alcruzr/UPS/Pictures/overall 5.jpg

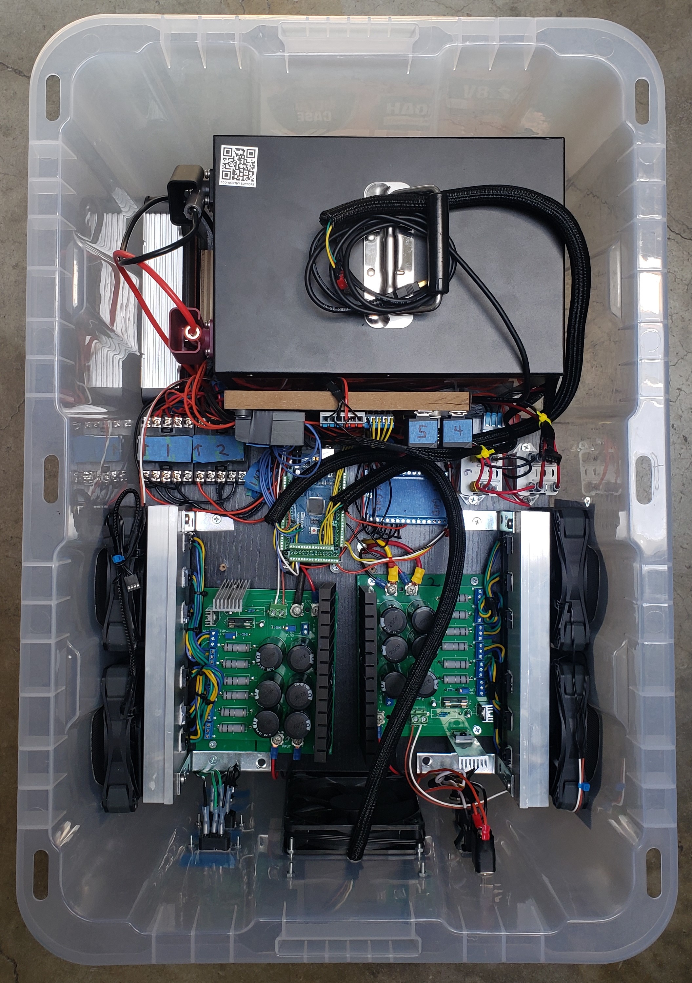
Pictures/overall 5.jpg
