alcruzr/UPS/Pictures/overall 4.jpg

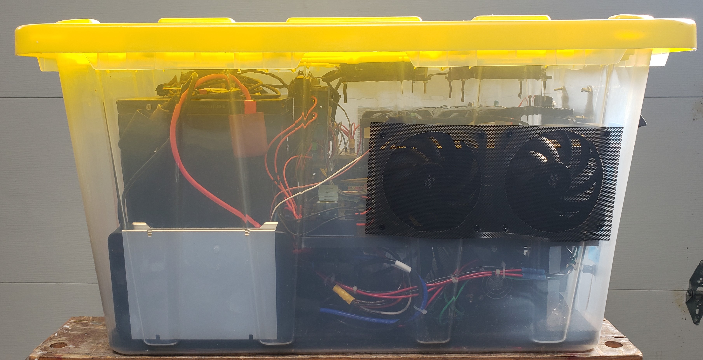
Pictures/overall 4.jpg
