alcruzr/UPS/Pictures/front.jpg

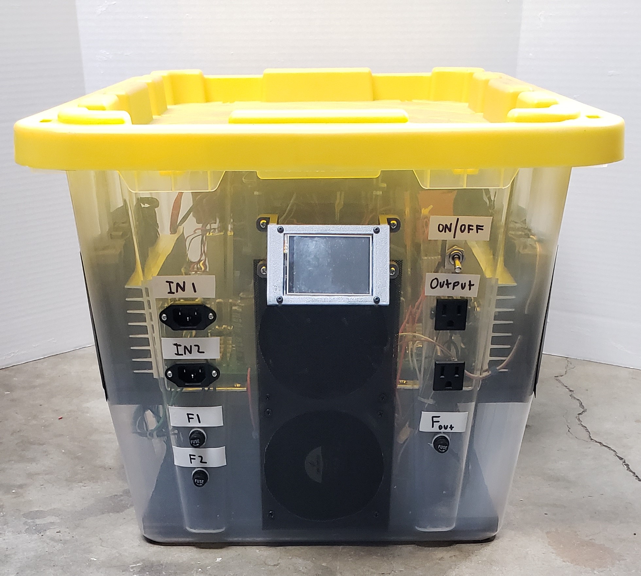
Pictures/front.jpg
