alcruzr/UPS/Pictures/screen.jpg

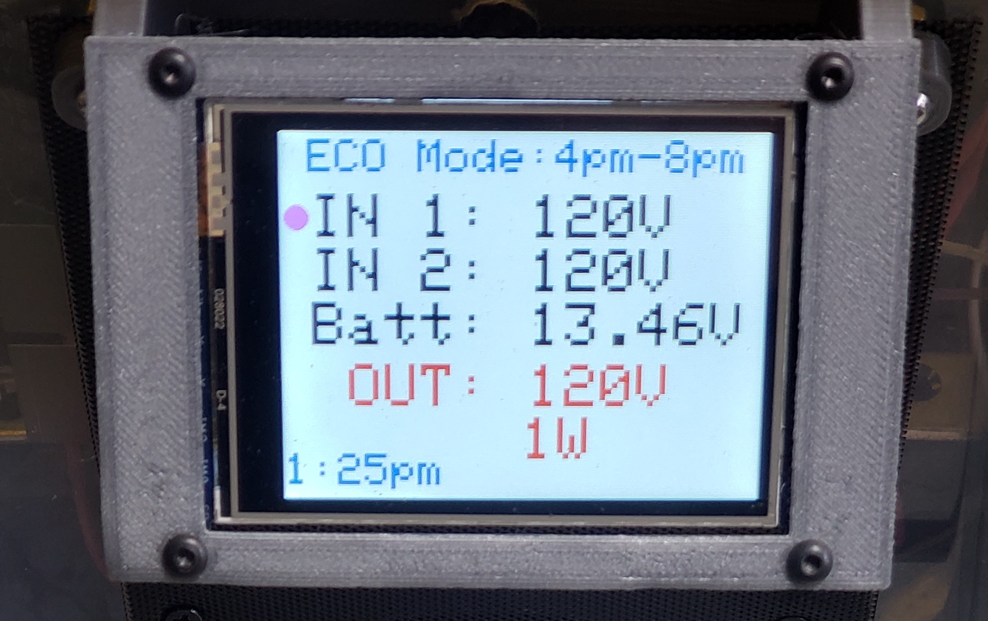
Pictures/screen.jpg
