alcruzr/UPS/UPS BOM-Final.xlsx

Part | Price | Required per Unit | Total Part Price
120V 40A AC Relay | $20.95 | 2 | $41.90 | https://www.lvelectronics.com/details/item?itemid=PICKER%20PC740-2C-C3-120A#
5V DC Relay | $25.07 | 2 | $50.14 | https://www.digikey.com/en/products/detail/panasonic-electric-works/SP2-DC5V/649191
5V DC Relay Screw Terminal | $11.32 | 2 | $22.64 | https://www.digikey.com/en/products/detail/panasonic-electric-works/SP2-SF/570886
6V DC Relay SPDT 40A | $3.15 | 2 | $6.30 | https://www.digikey.com/en/products/detail/cit-relay-and-switch/A2M1CSQ6VDC1-6/14001769
117/24V 40A AC Transformer | $212.30 | 1 | $212.30 | https://www.newark.com/hammond/1182w12/toroid-1000va-50-60hz-12-12v-rohs/dp/31AJ8188?ost=1182w12
Lithium Battery (150Ah) | $299.99 | 1 | $299.99 | https://www.amazon.com/ECO-WORTHY-Rechargeable-Phosphate-Protection-Motorhome/dp/B096FGMLNZ | https://www.eco-worthy.com/products/lifepo4-12v-150ah-lithium-iron-phosphate-battery?gad_source=1
AC Voltage Measurement Module | $6.99 | 3 | $20.97 | https://www.amazon.com/dp/B07D1WP884?psc=1&ref=ppx_yo2ov_dt_b_product_details
Microcontroller-Arduino Mega 2560 | $48.40 | 1 | $48.40
TFT Display (+$6 shipping) | $29.95 | 1 | $29.95 | https://www.adafruit.com/product/1770
RTC (Real Time Clock) | $11.49 | 1 | $11.49 | https://www.amazon.com/gp/product/B082LTHR28/ref=ppx_yo_dt_b_asin_image_o00_s01?ie=UTF8&psc=1
Buck Converter | $1.29 | 3 | $3.87 | https://www.amazon.com/gp/product/B07VVXF7YX/ref=ppx_yo_dt_b_search_asin_image?ie=UTF8&th=1
ULN2803A-Relay Driver Board | $3.22 | 1 | $3.22 | https://www.amazon.com/dp/B08QNHW4G4?psc=1&ref=ppx_yo2ov_dt_b_product_details
Fuse Holder | $1.99 | 3 | $5.97 | https://www.amazon.com/Joinfworld-Holder-Holders-Pre-Soldered-Fast-Blow/dp/B0BF9LDW1P?cv_ct_cx=fuse+holder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
SPST Switch | $2.21 | 1 | $2.21 | https://www.amazon.com/gp/product/B01M3U9V8Y/ref=ppx_yo_dt_b_search_asin_title?ie=UTF8&th=1
Inverter | $56.96 | 1 | $56.96 | https://www.amazon.com/gp/product/B09JZ2HTY9/ref=ppx_yo_dt_b_search_asin_title?ie=UTF8&psc=1
Charger | $108.99 | 1 | $108.99 | https://www.amazon.com/gp/product/B0BZCXNHDV/ref=ppx_yo_dt_b_search_asin_title?ie=UTF8&psc=1 | https://www.eco-worthy.com/collections/charge-controllers-inverters/products/12v-20a-40a-dc-to-dc-charger-on-board-mppt-battery-charger
Battery Ring Terminals | $2.49 | 2 | $4.98 | https://www.amazon.com/dp/B08HR1BD62?psc=1&ref=ppx_yo2ov_dt_b_product_details
AC Input Connectors | $4.17 | 2 | $8.34 | https://www.amazon.com/gp/product/B081VJ22G4/ref=ppx_yo_dt_b_search_asin_title?ie=UTF8&psc=1
AC Output Connectors | $2.99 | 2 | $5.98 | https://www.amazon.com/gp/product/B092VQNKN7/ref=ppx_yo_dt_b_search_asin_title?ie=UTF8&psc=1
Fans | $5.99 | 8 | $47.92 | https://www.amazon.com/gp/product/B0CLGMH1R8/ref=ppx_yo_dt_b_search_asin_title?ie=UTF8&th=1
Enclosure | $15.98 | 1 | $15.98 | https://www.homedepot.com/p/HDX-27-Gal-Storage-Tote-in-Clear-with-Yellow-Lid-206231/317211766
Rectifier PCB | $0.00 | 2 | $0.00
TIP2955 Transistor | $2.37 | 12 | $28.44 | https://www.digikey.com/en/products/detail/stmicroelectronics/TIP2955/603633
LT317A Voltage Regulator | $6.44 | 2 | $12.88 | https://www.digikey.com/en/products/detail/analog-devices-inc/LT317AT-PBF/891897
Diode | $2.22 | 2 | $4.44 | https://www.digikey.com/en/products/detail/stmicroelectronics/STPS60SM200CW/2700612
Full Bridge Rectifier | $1.85 | 2 | $3.70 | https://www.digikey.com/en/products/detail/panjit-international-inc/GBJ5010-T0-00601/16639574
Capacitor-10000uF 50V | $5.73 | 12 | $68.76 | https://www.digikey.com/en/products/detail/cornell-dubilier-knowles/380LX103M050J052/1699321
Capacitor-1uF 25V | $0.00 | 2 | $0.00
Capacitor-0.1uF 25V | $0.00 | 2 | $0.00
Resistor-50ohm | $0.00 | 2 | $0.00
Resistor-0.1ohm 5W | $0.00 | 12 | $0.00
Screw Terminal-Large-2 Pin | $1.25 | 2 | $2.50 | https://www.digikey.com/en/products/detail/amphenol-anytek/T70243500000G/2261340
Screw Terminal-Small-3 Pin (for transistor connections) | $0.14 | 12 | $1.68 | https://www.amazon.com/gp/product/B07H5G7GC6/ref=ppx_yo_dt_b_search_asin_title?ie=UTF8&psc=1
Screw Post | $4.51 | 8 | $36.08 | https://www.digikey.com/en/products/detail/w%C3%BCrth-elektronik/74655095R/6643999
Fuse Holder | $1.05 | 2 | $2.10 | https://www.digikey.com/en/products/detail/littelfuse-inc/64600001003/151822?s=N4IgTCBcDaIGwBY4AZXIIyoMwgLoF8g
Fuse 1.5A | $0.44 | 2 | $0.88
Heatsink-Full Bridge Rectifier | $9.99 | 2 | $19.98 | https://www.amazon.com/gp/product/B07VMMJCLY/ref=ppx_yo_dt_b_search_asin_title?ie=UTF8&psc=1
Heatsink-Diode | $1.99 | 2 | $3.98 | https://www.amazon.com/gp/product/B08NFBM4Q7/ref=ppx_yo_dt_b_search_asin_title?ie=UTF8&psc=1
Heatsink-Transistors | $17.00 | 2 | $34.00 | https://www.heatsinkusa.com/3-500-wide-extruded-aluminum-heatsink/
 |  | Total | $1227.92
