alcruzr/UPS/AC-DC Rectifier/BOM_AC_DC Rectifier 15.5V 20A v3.xlsx

No. | Quantity | Name | Designator | Value | Part Number | Comments
1 | 1 | Capacitor | C1 | 10000uF
2 | 1 | Capacitor | C2 | 10000uF
3 | 1 | Capacitor | C3 | 10000uF
4 | 1 | Capacitor | C4 | 10000uF
5 | 1 | Capacitor | C5 | 10000uF
6 | 1 | Capacitor | C6 | 10000uF
7 | 1 | Capacitor | C7 | 0.1uF
8 | 1 | Capacitor | C8 | 1uF
9 | 1 | Surface Pad | CN1
10 | 1 | Surface Pad | CN2
11 | 1 | Surface Pad | CN3
12 | 1 | Surface Pad | CN4
13 | 1 | Surface Pad | CN5
14 | 1 | Surface Pad | CN6
15 | 1 | Rectifier | D1 |  | GBJ5010_T0_00601
16 | 1 | Diode | D2 |  | STPS60SM200CW
17 | 1 | Fuse Holder | FH1 |  | 64600001003
18 | 1 | Transistor | Q1 |  | TIP2955 | Footprint for transistors does not match device footprint. Transistors are mounted to heatsink off board and connections are made with wires to the PCB. Footprints on PCB are for 3-pin screw treminal. https://www.amazon.com/gp/product/B07H5G7GC6/ref=ppx_yo_dt_b_search_asin_title?ie=UTF8&psc=1
19 | 1 | Transistor | Q2 |  | TIP2955
20 | 1 | Transistor | Q3 |  | TIP2955
21 | 1 | Transistor | Q4 |  | TIP2955
22 | 1 | Transistor | Q5 |  | TIP2955
23 | 1 | Transistor | Q6 |  | TIP2955
24 | 1 | Resistor | R1 | 0.1
25 | 1 | Resistor | R2 | 0.1
26 | 1 | Resistor | R3 | 0.1
27 | 1 | Resistor | R4 | 0.1
28 | 1 | Resistor | R5 | 0.1
29 | 1 | Resistor | R6 | 0.1
30 | 1 | Resistor | R7 | 50
31 | 1 | Resistor | R8 | 270
32 | 1 | Resistor ADJ | R9 | 3.2k
33 | 1 | Resistor ADJ | R10 | 9k
34 | 1 | Resistor | R11 | 4.7k
35 | 1 | Screw Post | U1 |  | 74655095R
36 | 1 | Screw Post | U2 |  | 74655095R
37 | 1 | LT317A | U3 |  | LT317AT#PBF
38 | 1 | Screw Terminal-Large-2 Pin | U5 |  | T70243500000G
39 | 1 | Screw Post | U6 |  | 74655095R
40 | 1 | Screw Post | U7 |  | 74655095R
41 | 1 | Screw Terminal | U9
