alcruzr/UPS/Schematics/UPS Circuit v2.8.pdf

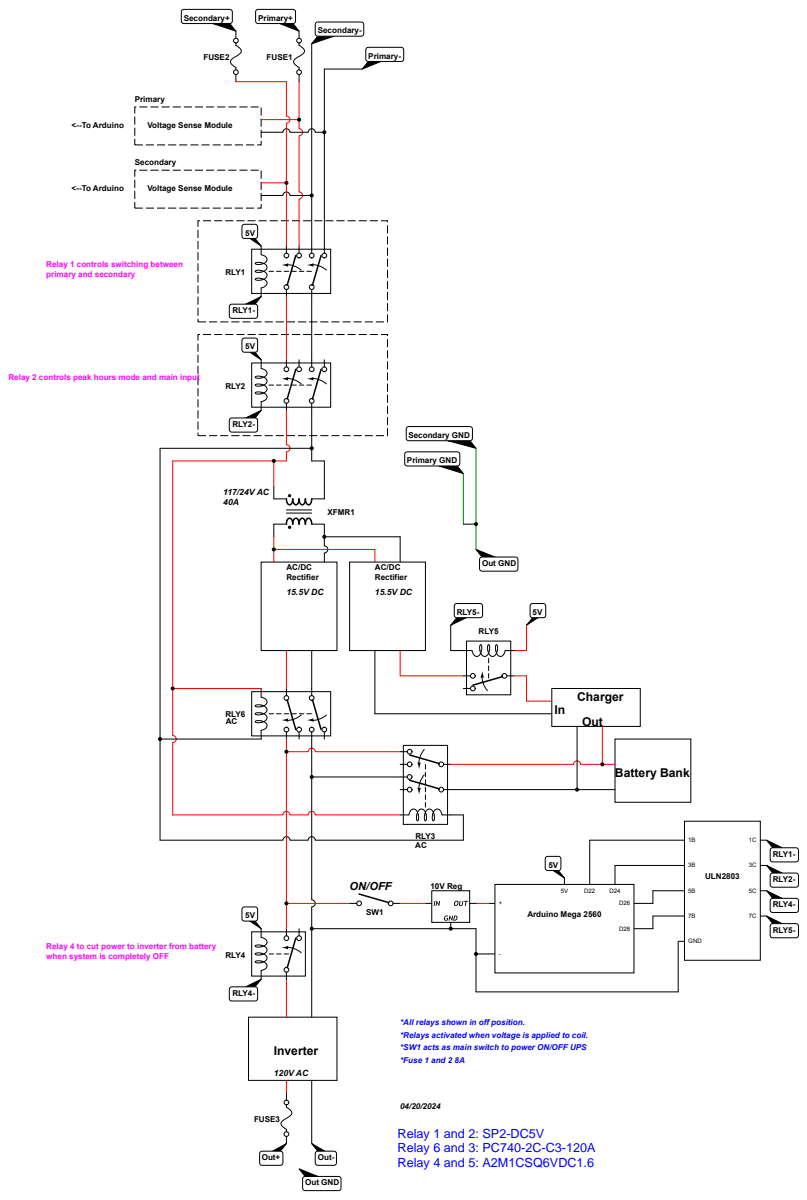
[picture p5: page 1]
Primary+; Primary-; Secondary+; Secondary-; RLY1-; RLY1; Arduino Mega 2560; RLY2-; RLY4-; Inverter; ON/OFF; Secondary GND; Primary GND; Out GND; RLY2; Out+; Out-; FUSE3; FUSE2; FUSE1; RLY5-; Primary; Secondary; <--To Arduino; Charger; Battery Bank; XFMR1; AC/DC Rectifier; RLY3; RLY6 AC; RLY5; RLY4; 10V Reg; ULN2803; GND; Out

Voltage Sense Module

Relay 1 controls switching between
primary and secondary

Relay 2 controls peak hours mode and main input

Relay 4 to cut power to inverter from battery
when system is completely OFF

*All relays shown in off position.
*Relays activated when voltage is applied to coil.
*SW1 acts as main switch to power ON/OFF UPS
*Fuse 1 and 2 8A
