alcruzr/UPS/AC-DC Rectifier/AC-DC Rectifier Schematic.pdf

### Main Input: 24V RMS AC

### TIP2955(x6)

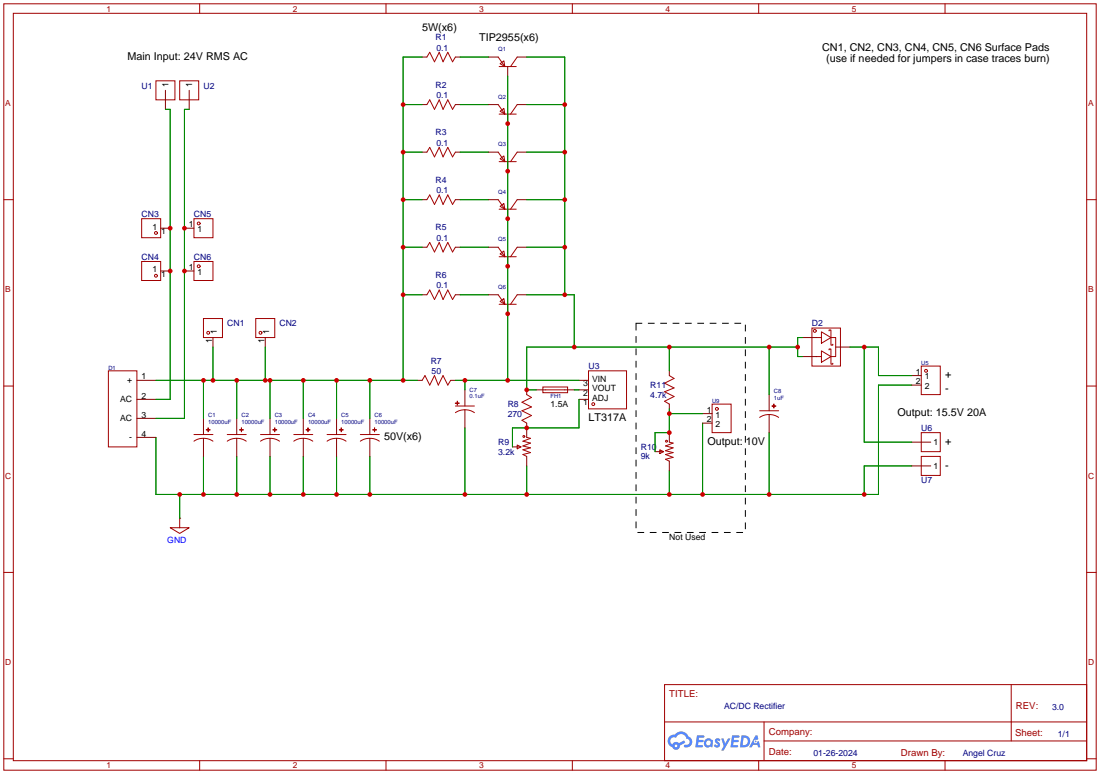
[picture p6: page 1]

CN1, CN2, CN3, CN4, CN5, CN6 Surface Pads
(use if needed for jumpers in case traces burn)
