alcruzr/UPS/Schematics/UPS-Microcontroller v4.pdf

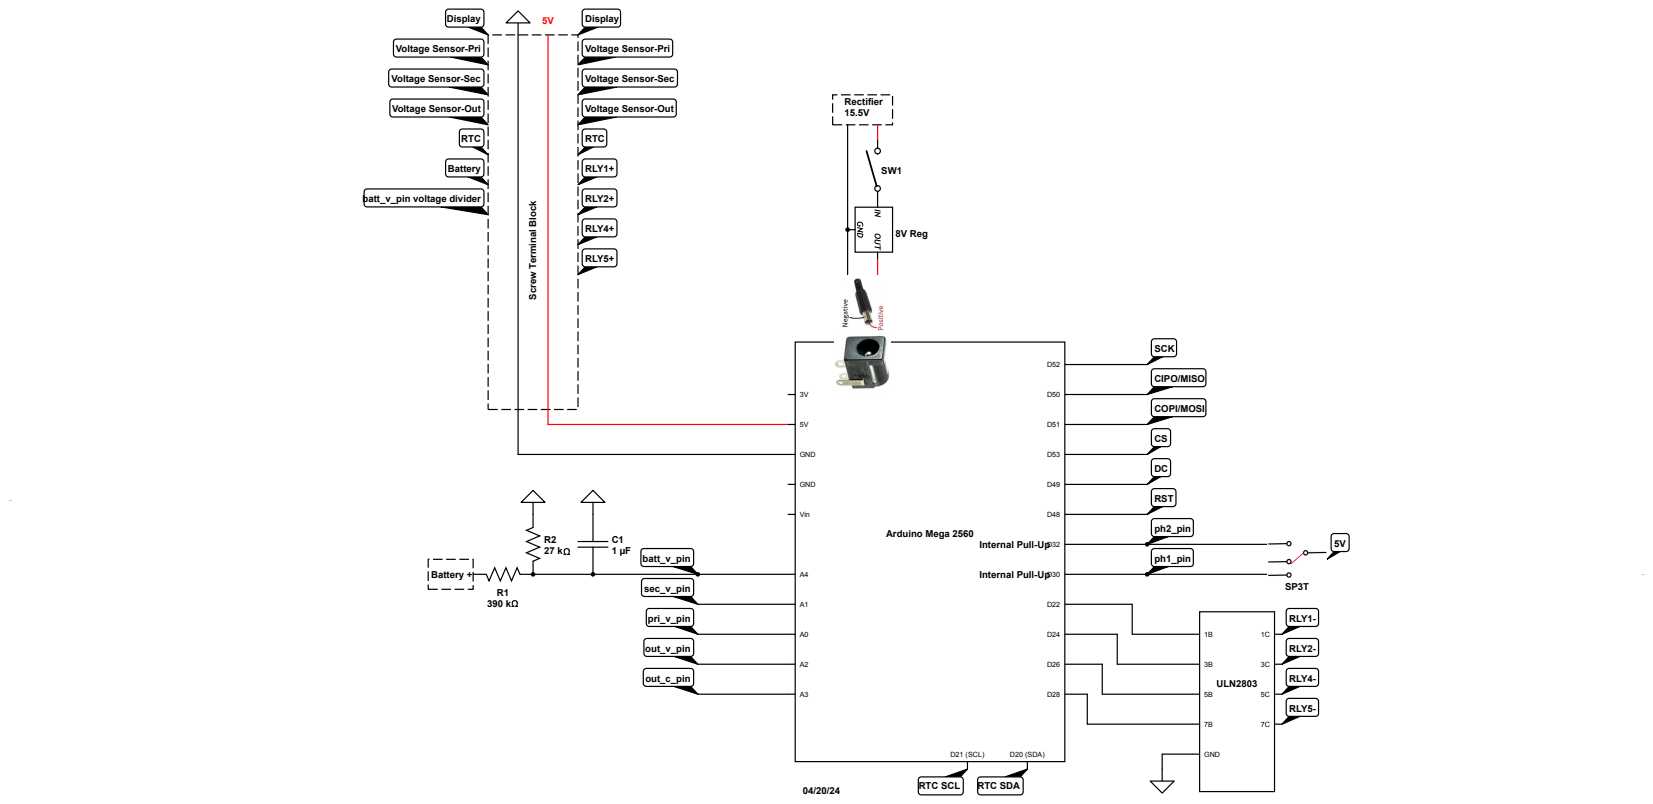
[picture p7: page 1]
