alcruzr/UPS/(commit log)

2024-01-06 separated code
    separated display code and added new file for voltage readings.
2024-01-06 incorporated voltage readings
2024-02-25 Voltage sense functions updated
2024-04-21 Create UPS BOM-Final 04-20-24.xlsx
    [UPS BOM-Final 04-20-24.xlsx]
2024-04-21 updated name
    [UPS BOM-Final.xlsx]
2024-04-21 created PCB documents
    [BOM_AC_DC Rectifier 15.5V 20A v3.xlsx]
2024-05-03 schematics added + current code added
